bcc6/joyMIDI-HW/joyMIDI/others/README.md

# Install InteractiveHtmlBom
Unzip and copy to folder C:\Program Files\KiCad\share\kicad\scripting\plugins
