bcc6/joyMIDI-HW/joyMIDI/schematic/Bottom.png

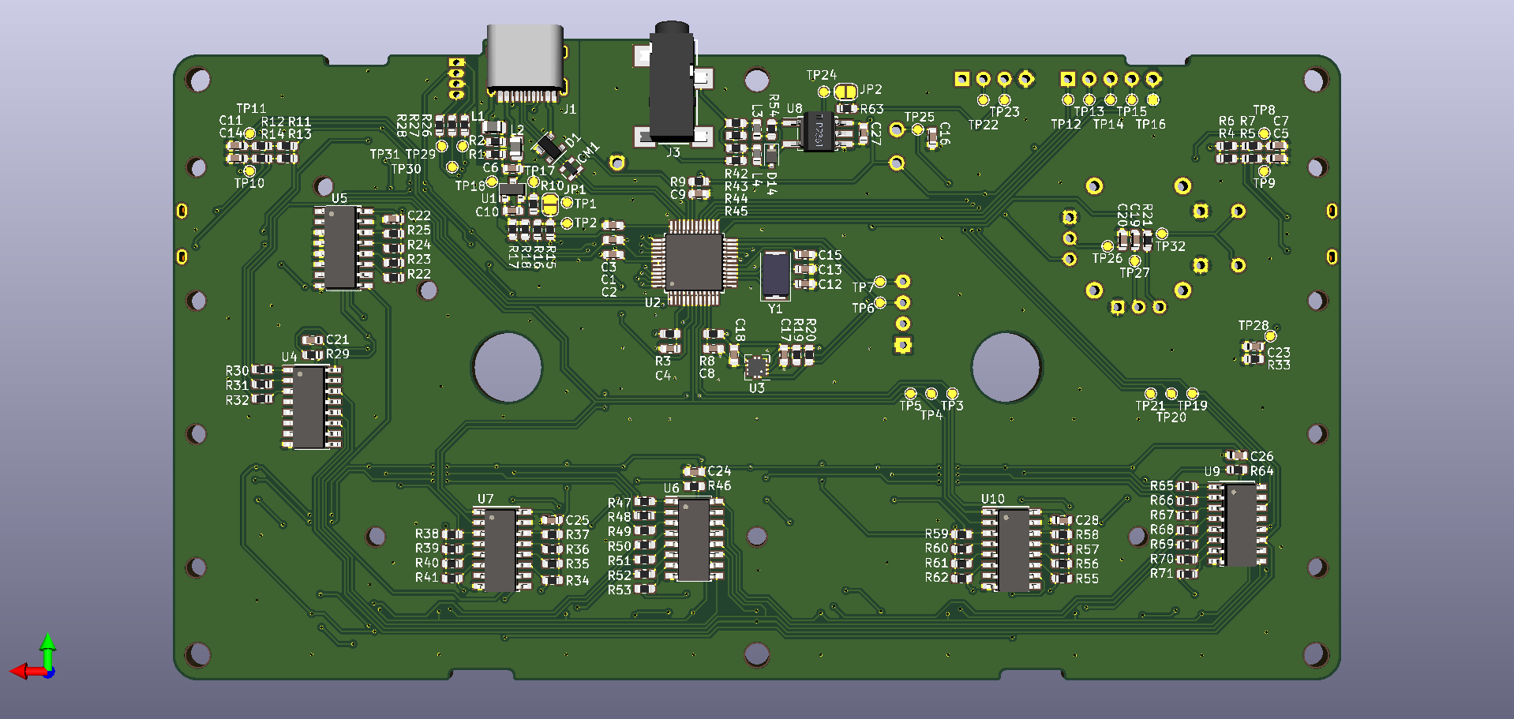
joyMIDI/schematic/Bottom.png
