bcc6/joyMIDI-HW/joyMIDI/schematic/Top.png

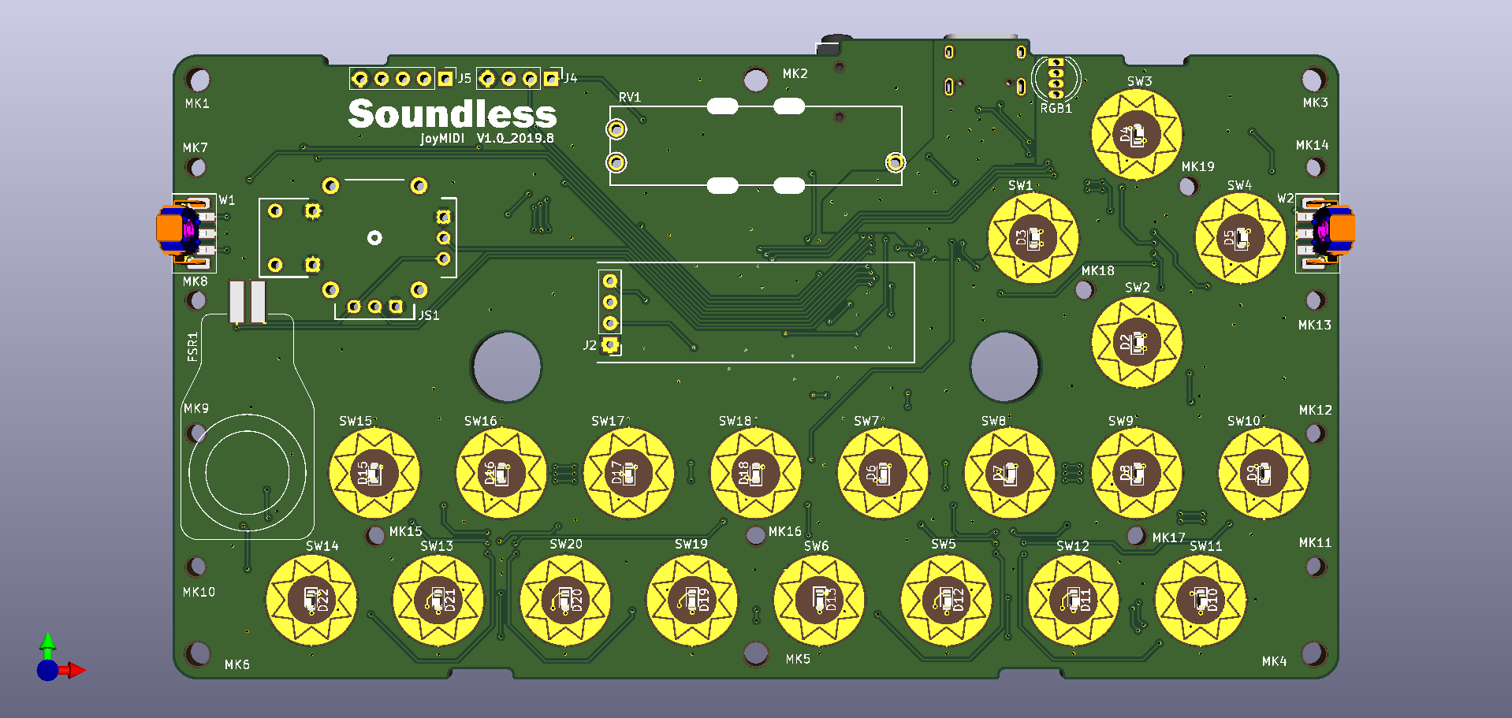
joyMIDI/schematic/Top.png
