bcc6/joyMIDI-HW/joyMIDI/__to_factory/joyMIDI_BOM _Parts (190529).xlsx

Sheet: BOM & PARTs
No. | Reference | P/N | Value | Package | Quantity | Mount
1 | C1, C2, C8, C9, C17, C18, C21, C22, C24, C25, C26, C27, C28 |  | 100n | C0603 | 13 | Yes
2 | C12, C13 |  | 20p | C0603 | 2 | Yes
3 | C16, C19, C20, C23 |  | 1n | C0603 | 4 | Yes
4 | C3, C4, C15 |  | 1u | C0603 | 3 | Yes
5 | C5, C7, C11, C14 |  | 10n | C0603 | 4 | Yes
6 | C6, C10 |  | 4.7u, 10V | C0603 | 2 | Yes
7 | CM1 | TDK, ACM2012-900-2P-TL002 | Common Choke, 90R@100MHz |  | 1 | Yes(0R)
8 | D1 | Nexperia, PRTR5V0U2X | ESD protection | SOT-143B | 1 | No
9 | D14 | 1N4148WS | Diode | SOD-323F | 1 | Yes
10 | D2, D3, D4, D5, D6, D7, D8, D9, D10, D11, D12, D13, D15, D16, D17, D18, D19, D20, D21, D22 | Everlight, 19-217/W1D | LED, Pure White | LED0603 | 20 | Yes
11 | FSR1 | Uneo, GD10-20N | Forcing sensing resister |  | 1 | Yes | http://www.uneotech.com/uneo/us/online-store-4/96/gs0001-4-uneo.html Eric Huang 黃爾均 <erichuang@uneotech.com>
12 | J1 | Amphenol, 12401610E4#2A | USB Type C, Receptacle |  | 1 | Yes
13 | J2 |  | Pin Header (OLED) | 1x4_2.54mm | 1 | Yes
14 | J3 | CUI, SJ-2524-SMT | Audio Jack, 2.5mm |  | 1 | Yes
15 | J4 |  | Pin Header (Debug) | 1x4_2.54mm | 1 | No
16 | J5 |  | Pin Header (Programmer) | 1x5_2.54mm | 1 | No
17 | JS1 | 普耀(福哥), FJM10K-S1B10K | Joystick |  | 1 | Yes | http://www.polyshine.cn/uploadFile/FJM10K-2013-12-02-04-50-09.pdf
18 | L1 |  | 0R | L0805 | 1 | No
19 | L2 |  | Ferrite Bead, 600R, 1A | L0805 | 1 | Yes (0R)
20 | L3, L4 | TDK, MMZ1608Y102BT | Ferrite Bead | L0603 | 2 | Yes (0R)
21 | R1, R2 |  | 5.1K | R0603 | 2 | Yes
22 | R19, R20 |  | 4.7K | R0603 | 2 | Yes
23 | R26, R27, R28, R54 |  | 220 | R0603 | 4 | Yes
24 | R29, R30, R31, R32, R46, R47, R48, R49, R50, R51, R52, R53, R64, R65, R66, R67, R68, R69, R70, R71 |  | 1K | R0603 | 20 | Yes
25 | R3, R4, R5, R6, R7, R11, R12, R13, R14, R21, R22, R23, R24, R25, R34, R35, R36, R37, R38, R39, R40, R41, R55, R56, R57, R58, R59, R60, R61, R62 |  | 10K | R0603 | 30 | Yes
26 | R33 |  | 2K | R0603 | 1 | Yes
27 | R43, R44 |  | NC | R0603 | 2 | No
28 | R8, R9, R10, R15, R16, R17, R18, R42, R45, R63 |  | 0R | R0603 | 10 | Yes
29 | RV1 | 普耀(福哥), F2031-NN0SC2B10K | Slider, Travel 20mm, 3Pin 10KOhm | (操作力度為最鬆) | 1 | Yes | http://www.polyshine.cn/uploadFile/Fxx31-2015-09-21-01-46-32.pdf
30 | RGB1 |  | LED, RGB Clear Common Anode | D4.8mm-4pin, Straw hat | 1 | Yes | https://detail.1688.com/offer/1232851898.html?spm=a2615.7691456.newlist.51.319e58cc8Eowc5
31 | U1 | AIC, AIC1746-33(GU3TR, PK3TR) | LDO, 3.3V | SOT-23 | 1 | Yes
32 | U2 | Nuvoton, M452LE6AE | MCU, 128K/32K | LQFP-48, 7x7mm | 1 | Yes
33 | U3 | Bosch, BMA253 | G-sensor | LGA-12, 2x2mm | 1 | Yes | https://www.mouser.com/datasheet/2/783/Bosch_01242017_BMA253-1217713.pdf
34 | U4, U6, U9 | 74HC595D |  | SOIC-16, 3.9x9.9mm | 3 | Yes
35 | U5, U7, U10 | 74HC165D |  | SOIC-16, 3.9x9.9mm | 3 | Yes
36 | U8 | Toshiba, TLP2361 | Photocoupler | SO-5, 4.4x3.6mm | 1 | Yes
37 | W1, W2 | ALPS, EC05E1220202 | Encoder |  | 2 | Yes | https://www.alps.com/prod/info/E/HTML/Encoder/Incremental/EC05E/EC05E1220202.html
38 | Y1 | TXC, 7A-12.000MAAJ-T | 12MHz, 20pf | SMD 5032, 2Pin | 1 | Yes
No. | Reference | P/N | Value | Package | Quantity | Mount
1 | OLED |  | 128x32, White color, I2C | 0.91" | 1 | Yes | https://item.taobao.com/item.htm?spm=a1z09.2.0.0.46752e8dvI4tNo&id=41978488408&_u=32he15hv61af
2 | Optical fiber |  | SOTT-4 | Φ 4mm (裁切長度為 55mm) | 1 | Yes | https://item.taobao.com/item.htm?spm=a312a.7700824.w4002-2232455176.13.4ecf4f0cVMZXpB&id=16114844505
3 | Heat shrink tube |  |  | Φ 5mm (裁切長度為 16mm) | 1 | Yes
4 | Joystick cap |  | Plastic |  | 1 | Yes | https://item.taobao.com/item.htm?spm=a1z09.2.0.0.46752e8dkIGIcR&id=556587653085&_u=42he15hv3e95
5 | Slider cap |  | Plastic |  | 1 | Yes | https://item.taobao.com/item.htm?id=566418891937&ns=1&abbucket=8 (https://item.taobao.com/item.htm?spm=a230r.1.14.61.41f04349yJPBXQ&id=566418891937&ns=1&abbucket=8)
6 | PCB |  | Matte Black / White font

Sheet: Price
No. | Reference | P/N | Value | Package | Qty | Mount | 需求數量 | 實際數量 | $(美金) |  | 註解 | pads
1 | C1, C2, C8, C9, C17, C18, C21, C22, C24, C25, C26, C27, C28 |  | 100n | C0603 | 13 | Yes | 6500 | 8000 | 9.86 | 淘寶(华科洋) | CC0603KRX7R9BB104 | 2
2 | C12, C13 |  | 20p | C0603 | 2 | Yes | 1000 | 4000 | 6.9574 | 淘寶(华科洋) | CC0603JRNPO9BN200 | 2
3 | C16, C19, C20, C23 |  | 1n | C0603 | 4 | Yes | 2000 | 4000 | 6.9574 | 淘寶(华科洋) | CL10B102KB8NNNC | 2
4 | C3, C4, C15 |  | 1u | C0603 | 3 | Yes | 1500 | 4000 | 6.9574 | 淘寶(华科洋) | CL10B105KO8NNNC | 2
5 | C5, C7, C11, C14 |  | 10n | C0603 | 4 | Yes | 2000 | 4000 | 6.9574 | 淘寶(华科洋) | CL10B103KB8NNNC | 2
6 | C6, C10 |  | 4.7u, 10V | C0603 | 2 | Yes | 1000 | 4000 | 6.9574 | 淘寶(华科洋) | CL10A475KP8NNNC | 2
7 | CM1 | TDK, ACM2012-900-2P-TL002 | Common Choke, 90R@100MHz |  | 1 | Yes | 500 | 2000 | 57.99 | 淘寶(銘晖) | ACM2012-900-2P-T002 0805 90R | 4
8 | D1 | Nexperia, PRTR5V0U2X | ESD protection | SOT-143B | 1 | Yes | 500 | 3000 | 69.57 | 淘寶(锴成达) | PRTR5V0U2X | 4
9 | D14 | 1N4148WS | Diode | SOD-323F | 1 | Yes | 500 | 3000 | 17.39 | 淘寶(华科洋) | 1N4148WS SOD-323 丝印T4 | 2
10 | D2, D3, D4, D5, D6, D7, D8, D9, D10, D11, D12, D13, D15, D16, D17, D18, D19, D20, D21, D22 | Everlight, 19-217/W1D | LED, Pure White | LED0603 | 20 | Yes | 10000 | 12000 | 43.48 | 淘寶(华科洋) | 不明品牌 | 2
11 | FSR1 | Uneo, GD10-20N | Forcing sensing resister |  | 1 | Yes | 500 | 1000 | 1087.07 | 1688(力感科技) | RP-C10-ST | 2
12 | J1 | SHWB, USCX-16FX-XXMX-21 | USB Type C, Receptacle, 16pin |  | 1 | Yes | 500 | 500 | 27.49 | 1688(深洪威博) | USCX-16FX-XXMX-21 | 20
13 | J2 |  | Pin Header (OLED) | 1x4_2.54mm | 1 | No | 0 | 0 | 0 |  |  | 0
14 | J3 | CUI, SJ-2524-SMT | Audio Jack, 2.5mm |  | 1 | Yes | 500 | 1000(strip) | 28.97 | 淘寶(博泰鑫) | PJ-208A | 4
15 | J4 |  | Pin Header (Debug) | 1x4_2.54mm | 1 | No |  | 0 | 0 |  |  | 0
16 | J5 |  | Pin Header (Programmer) | 1x5_2.54mm | 1 | No |  | 0 | 0 |  |  | 0
17 | JS1 | 普耀(福哥), FJM10K-S1B10K | Joystick |  | 1 | Yes | 500 | 500 | 144.66 | 淘寶(金鑫开关) | FJM10K-S1B10K | 14
18 | L1 |  | 0R | L0805 | 1 | No |  | 0 | 0 |  |  | 0
19 | L2 |  | Ferrite Bead, 600R, 1A | L0805 | 1 | Yes (0R) | 500 | 5000 | 3.88 | 淘寶(华科洋) | 0805 0R 1% | 2
20 | L3, L4 | TDK, MMZ1608Y102BT | Ferrite Bead | L0603 | 2 | Yes | 1000 | 4000 | 6.36 | 淘寶(华科洋) | GZ1608D102TF | 2
21 | R1, R2 |  | 5.1K | R0603 | 2 | Yes | 1000 | 5000 | 2.29 | 淘寶(华科洋) | 0603 5.1K 1% | 2
22 | R19, R20 |  | 4.7K | R0603 | 2 | Yes | 1000 | 5000 | 2.29 | 淘寶(华科洋) | 0603 4.7K 1% | 2
23 | R26, R27, R28, R54 |  | 220 | R0603 | 4 | Yes | 2000 | 5000 | 2.29 | 淘寶(华科洋) | 0603 220R 1% | 2
24 | R29, R30, R31, R32, R46, R47, R48, R49, R50, R51, R52, R53, R64, R65, R66, R67, R68, R69, R70, R71 |  | 1K | R0603 | 20 | Yes | 10000 | 15000 | 6.87 | 淘寶(华科洋) | 603 1K 1% | 2
25 | R3, R4, R5, R6, R7, R11, R12, R13, R14, R21, R22, R23, R24, R25, R34, R35, R36, R37, R38, R39, R40, R41, R55, R56, R57, R58, R59, R60, R61, R62 |  | 10K | R0603 | 30 | Yes | 15000 | 20000 | 9.16 | 淘寶(华科洋) | 0603 10K 1% | 2
26 | R33 |  | 3.3K | R0603 | 1 | Yes | 500 | 5000 | 2.29 | 淘寶(华科洋) | 0603 3.3K 1% | 2
27 | R43, R44 |  | NC | R0603 | 2 | No |  | 0 | 0 |  |  | 0
28 | R8, R9, R10, R15, R16, R17, R18, R42, R45, R63 |  | 0R | R0603 | 10 | Yes | 5000 | 10000 | 4.58 | 淘寶(华科洋) | 0603 0R 1% | 2
29 | RV1 | 普耀(福哥), F2031-NN0SC2B10K | Slider, Travel 20mm, 3Pin 10KOhm |  | 1 | Yes | 500 | 500 | 79.56 | 1688(东莞博聪) | SL2031N | 3
30 | RGB1 |  | LED, RGB Clear Common Anode | D4.8mm-4pin, Straw hat | 1 | Yes | 500 | 500 | 14.47 | 1688(亚磊) |  | 4
31 | U1 | AIC, AIC1746-33(GU3TR, PK3TR) | LDO, 3.3V | SOT-23 | 1 | Yes | 500 | 1000(strip) | 57.85 | 淘寶(pingcon) | AIC1746-33PK3TR | 3
32 | U2 | Nuvoton, M452LE6AE | MCU, 128K/32K | LQFP-48, 7x7mm | 1 | Yes | 500 | 500 | 925 | nuvoton direct | M452LE6AE | 48
33 | U3 | Bosch, BMA253 | G-sensor | LGA-12, 2x2mm | 1 | Yes | 500 | 1000(strip) | 209.69 | 淘寶(浩吉发) | STK8BA53 | 12
34 | U4, U6, U9 | 74HC595D |  | SOIC-16, 3.9x9.9mm | 3 | Yes | 1500 | 2500 | 115.69 | 淘寶(华科洋) | ¥0.32 | 16
35 | U5, U7, U10 | 74HC165D |  | SOIC-16, 3.9x9.9mm | 3 | Yes | 1500 | 2500 | 115.69 | 淘寶(华科洋) | ¥0.32 | 16
36 | U8 | Toshiba, TLP2361 | Photocoupler | SO-5, 4.4x3.6mm | 1 | Yes | 500 | 1000(strip) | 231.38 | 淘寶(兴宏泰) | 需再詢價 | 5
37 | W1, W2 | ALPS, EC05E1220202 | Encoder |  | 2 | Yes | 1000 | 1000(strip) | 477.37 | 淘寶(涛利) | 需再詢價 | 7
38 | Y1 | TXC, 7A-12.000MAAJ-T | 12MHz, 20pf | SMD 5032, 2Pin | 1 | Yes | 500 | 1000 | 79.54 | 淘寶(华科洋) | ¥0.55, 12MHZ 20PF ±10PPM | 2
 |  |  |  |  |  |  |  |  | 3867.517 |  |  | 198
No. | Reference | P/N | Value | Package | Qty | Mount | 需求數量 | 實際數量 | $(美金)
1 | OLED |  | 128x32, White color, I2C | 0.91" | 1 |  | 500 | 500 | 759.22 | 淘寶(叁陆壹) | 焊排針
2 | Optical fiber |  | SOTT-4 | Φ 4mm (裁切長度為 55mm) | 1 |  | 30 | 30 | 39.05 | 淘寶(四叶子) | 共約30米
3 | Heat shrink tube |  |  | Φ 5mm (裁切長度為 16mm) | 1 |  | 10 | 10 | 6.1 | 露天(heat2020) | 共約10米
4 | Joystick cap |  | Plastic |  | 1 |  | 500 | 500 | 47.01 | 淘寶(华智)
5 | Slider cap |  | Plastic |  | 1 |  | 500 | 500 | 20.97 | 淘寶(华图贸易)
6 | PCB |  | Matte Black / White font | 8連板 | 1 |  | 500 | 500 | 1000 | 淘寶(快客電路) | 需再詢價
7 | 鋼板 |  |  |  | 1 |  | 1 | 1 | 100 | 淘寶(快客電路) | 需再詢價
8 | SMT |  |  |  | 1 |  | 1 | 1 | 1200 | 淘寶(快客電路) | 需再詢價
9 | 包材 |  |  |  |  |  |  |  | 0
 |  |  |  |  |  |  |  |  | 3172.35
