bcc6/joyMIDI-HW/joyMIDI/others/dxf/Placement.DXF

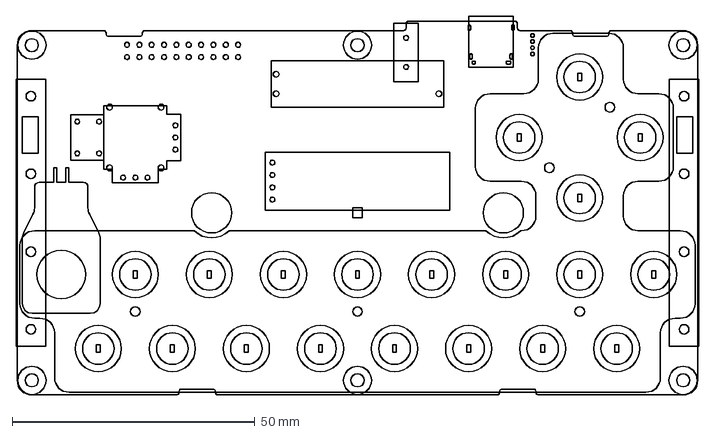
[picture p3: CAD file, 2019-04-24]
joyMIDI/others/dxf/Placement.DXF
140.4 x 78.0 mm
