bcc6/joyMIDI-HW/joyMIDI/others/Solidworks-RubberPad/RubberPad.SLDPRT

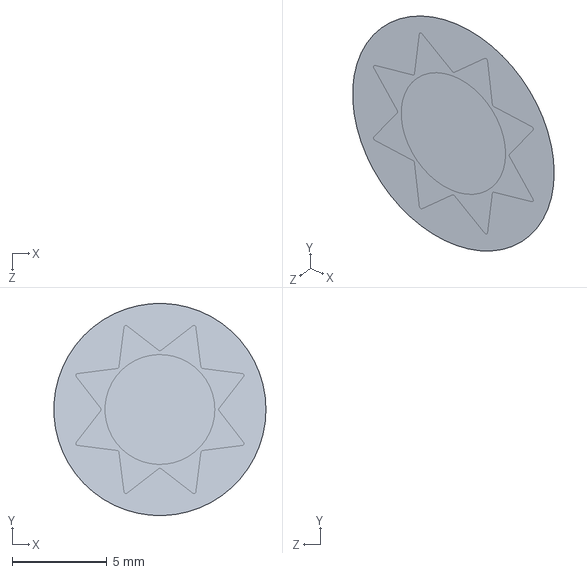
[picture p4: CAD file, 2019-04-24]
joyMIDI/others/Solidworks-RubberPad/RubberPad.SLDPRT
11.2 x 11.2 x 0 mm
