bcc6/joyMIDI-HW/joyMIDI/others/dxf/EdgeCut.DXF

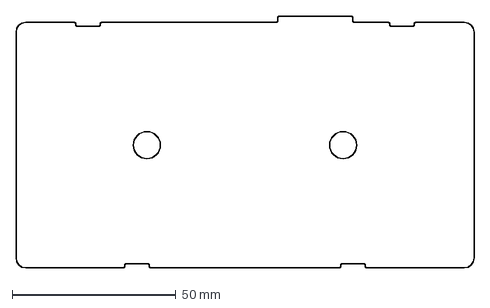
[picture p5: CAD file, 2019-04-24]
joyMIDI/others/dxf/EdgeCut.DXF
140.0 x 76.9 mm
