bcc6/joyMIDI-HW/(list of files, cad)

Other CAD files:
joyMIDI/others/Solidworks-RubberPad/RubberPad.DXF
