bcc6/joyMIDI-HW/joyMIDI/schematic/joyMIDI - schematic.pdf

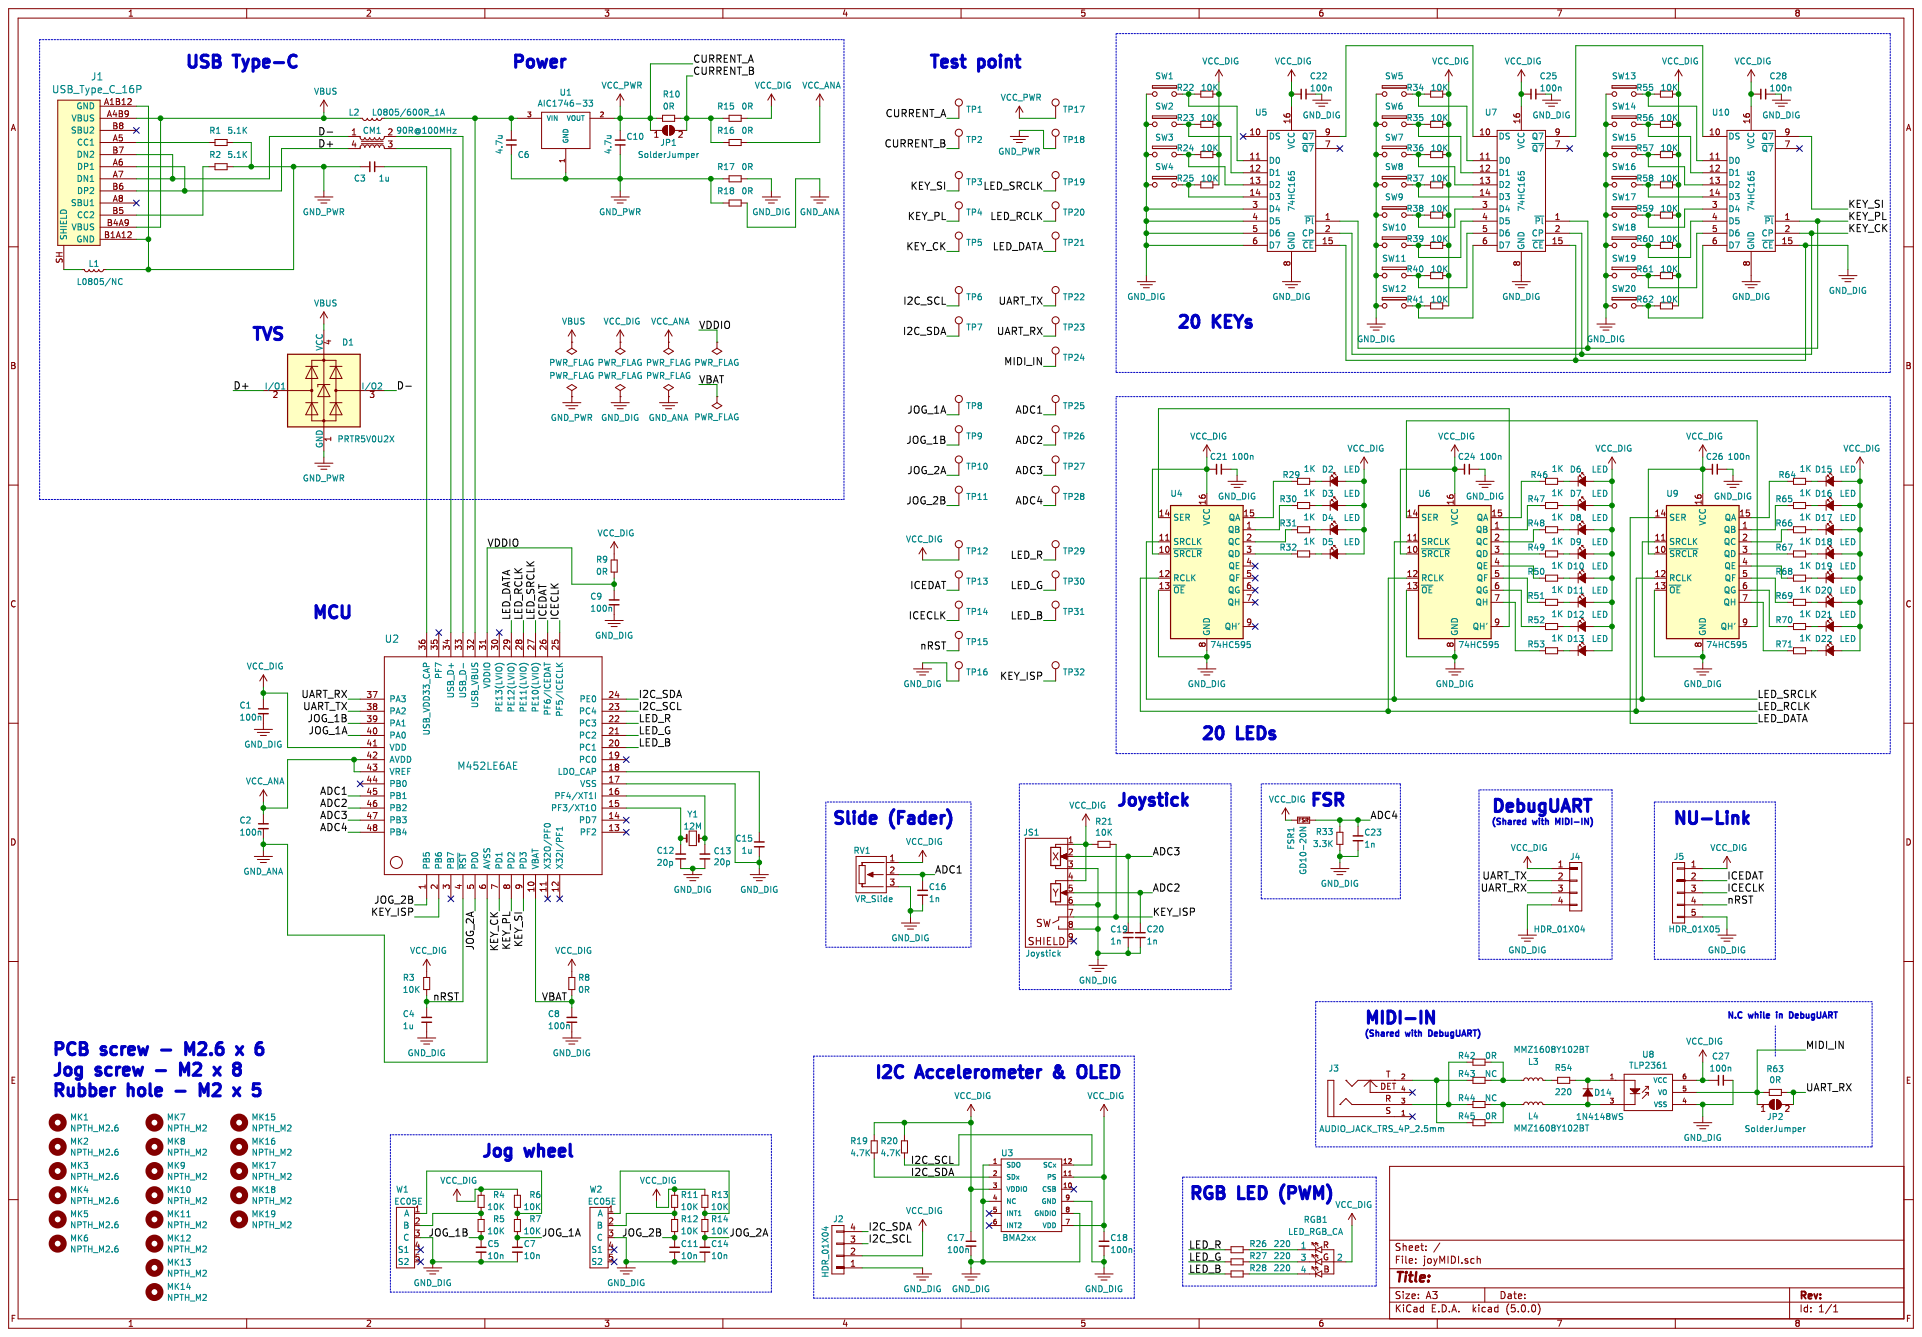
[picture p6: page 1]
