bcc6/joyMIDI-HW/joyMIDI/joyMIDI.kicad_pcb

## KiCad design joyMIDI/joyMIDI.kicad_pcb (2019-08-20)

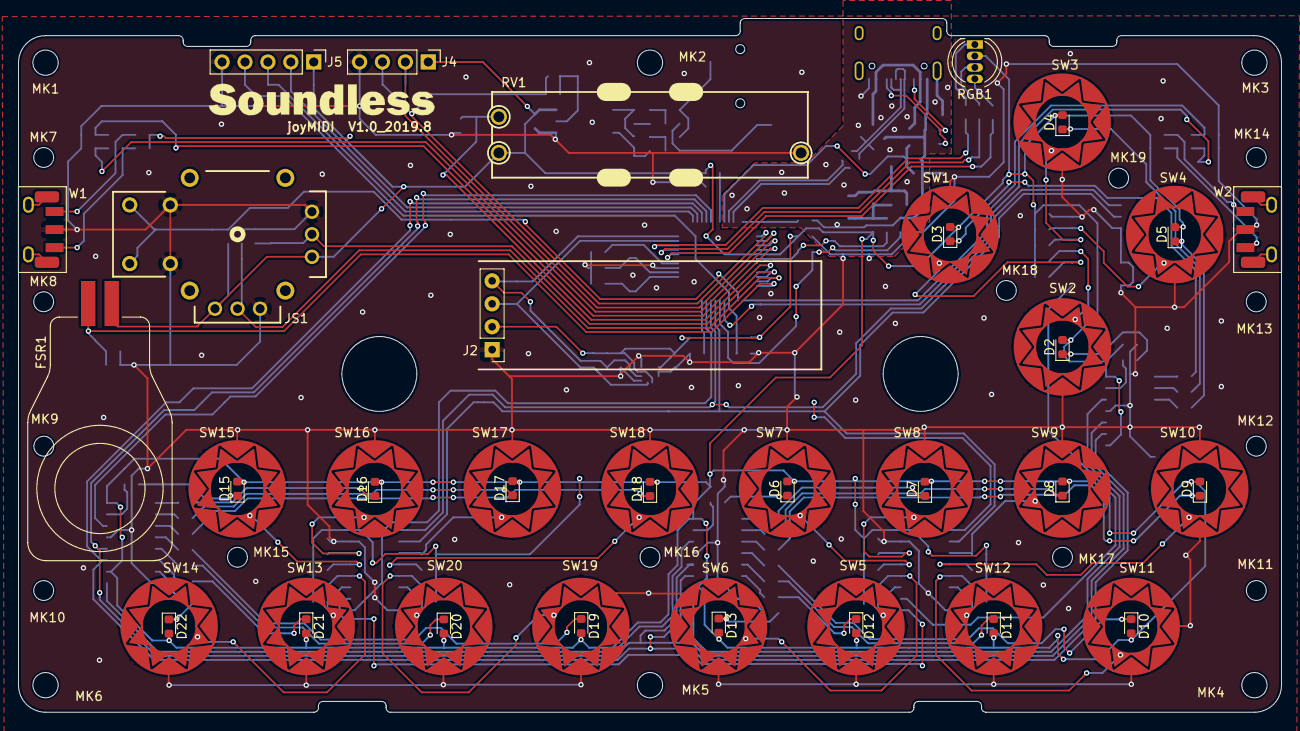
[picture p7: board joyMIDI.kicad_pcb from above]

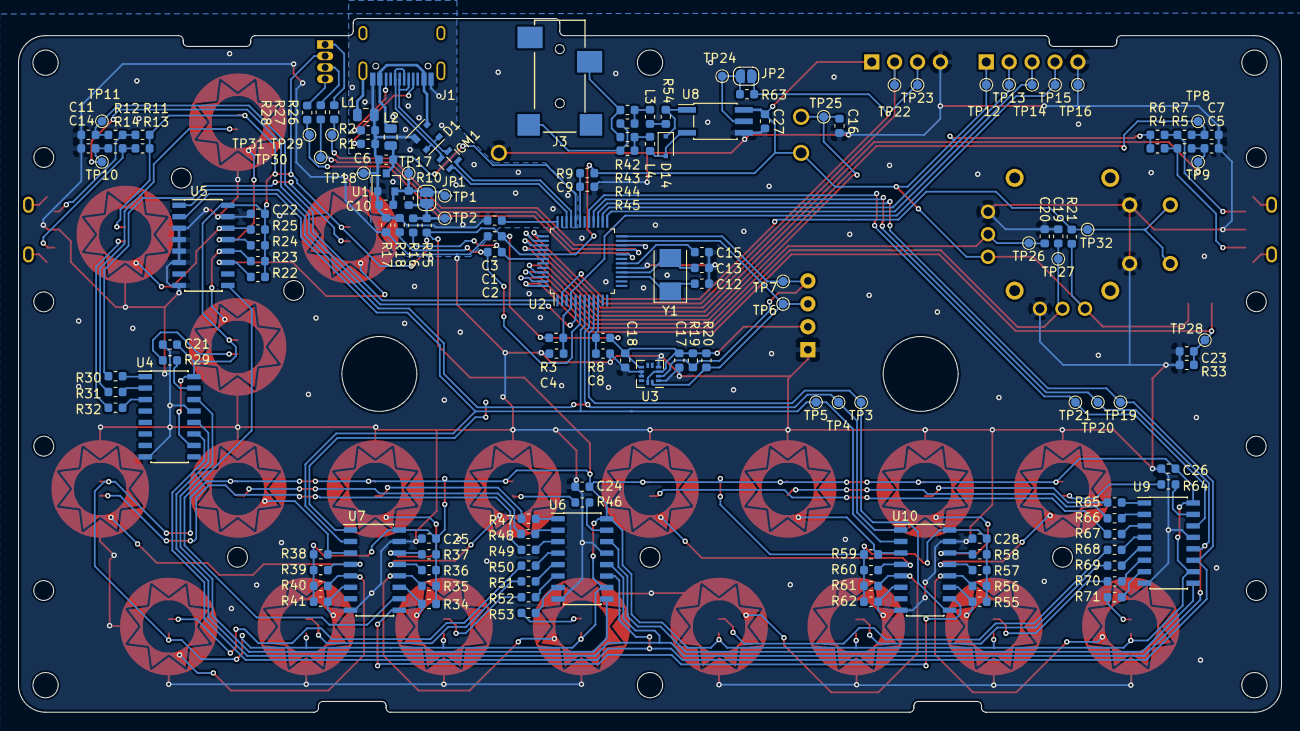
[picture p8: board joyMIDI.kicad_pcb from below]

Board: 2 copper layers, 140.0 x 76.9 mm, 221 parts (153 on the bottom side), 126 nets.

Parts:
C1, C2, C8, C9, C17, C18, C21, C22, C24, C25, C26, C27, C28: 100n; C_0603_1608Metric
C3, C4, C15: 1u; C_0603_1608Metric
C5, C7, C11, C14: 10n; C_0603_1608Metric
C6, C10: 4.7u; C_0603_1608Metric
C12, C13: 20p; C_0603_1608Metric
C16, C19, C20, C23: 1n; C_0603_1608Metric
CM1: 90R@100MHz; CommonChoke_Dual0603
D1: PRTR5V0U2X; PRTR5V0U2X_SOT-143B
D2, D3, D4, D5, D6, D7, D8, D9, D10, D11, D12, D13, D15, D16, D17, D18, D19, D20, D21, D22: LED; LED_0603_1608Metric
D14: 1N4148WS; D_SOD-323F
FSR1: GD10-20N; FSR_GD10-20N
J1: USB_Type_C_16P; HRO_TYPE-C-31-M-12
J2: HDR_01X04; Pin_Header_Straight_1x04_Pitch2.54mm_SmallHole
J3: AUDIO_JACK_TRS_4P_2.5mm; AUDIO_JACK_2.5mm_SJ-2524-SMT
J4: HDR_01X04; PinHeader_1x04_P2.54mm_Vertical
J5: HDR_01X05; PinHeader_1x05_P2.54mm_Vertical
JP1, JP2: SolderJumper; SolderJumper-2_P1.3mm_Open_RoundedPad1.0x1.5mm
JS1: Joystick; Joystick_FJM10K-S
L1: L0805/NC; L_0805_2012Metric
L2: L0805/600R_1A; L_0805_2012Metric
L3, L4: MMZ1608Y102BT; L_0603_1608Metric
MK1, MK2, MK3, MK4, MK5, MK6: NPTH_M2.6; NPTH_2.8mm_M2.6
MK7, MK8, MK9, MK10, MK11, MK12, MK13, MK14, MK15, MK16, MK17, MK18, MK19: NPTH_M2; NPTH_2.2mm_M2
R1, R2: 5.1K; R_0603_1608Metric
R3, R4, R5, R6, R7, R11, R12, R13, R14, R21, R22, R23, R24, R25, R34, R35, R36, R37, R38, R39, R40, R41, R55, R56, R57, R58, R59, R60, R61, R62: 10K; R_0603_1608Metric
R8, R9, R10, R15, R16, R17, R18, R42, R45, R63: 0R; R_0603_1608Metric
R19, R20: 4.7K; R_0603_1608Metric
R26, R27, R28, R54: 220; R_0603_1608Metric
R29, R30, R31, R32, R46, R47, R48, R49, R50, R51, R52, R53, R64, R65, R66, R67, R68, R69, R70, R71: 1K; R_0603_1608Metric
R33: 3.3K; R_0603_1608Metric
R43, R44: NC; R_0603_1608Metric
RGB1: LED_RGB_CA; LED_D4.8mm-4
RV1: VR_Slide; VR_Slide_F2031-NN
SW1, SW2, SW3, SW4, SW5, SW6, SW7, SW8, SW9, SW10, SW11, SW12, SW13, SW14, SW15, SW16, SW17, SW18, SW19, SW20: SW; RubberPad
TP1, TP2, TP3, TP4, TP5, TP6, TP7, TP8, TP9, TP10, TP11, TP12, TP13, TP14, TP15, TP16, TP17, TP18, TP19, TP20, TP21, TP22, TP23, TP24, TP25, TP26, TP27, TP28, TP29, TP30, TP31, TP32: TestPoint; TestPoint_Pad_D1.0mm
U1: AIC1746-33; SOT-23
U2: M452LE6AE; LQFP-48_7x7mm_P0.5mm
U3: BMA2xx; BMA2xx_LGA-12
U4, U6, U9: 74HC595; SOIC-16_3.9x9.9mm_P1.27mm
U5, U7, U10: 74HC165; SOIC-16_3.9x9.9mm_P1.27mm
U8: TLP2361; SO-5_4.4x3.6mm_P1.27mm
W1, W2: EC05E; EC05E1220202
Y1: 12M; Crystal_SMD_5032-2Pin_5.0x3.2mm

Connections:
/ADC1: C16.1, RV1.2, TP25.1, U2.45
/ADC2: C20.1, JS1.5, TP26.1, U2.46
/ADC3: C19.1, JS1.2, TP27.1, U2.47
/ADC4: C23.1, FSR1.1, R33.2, TP28.1, U2.48
/CURRENT_B: JP1.2, R10.1, R15.2, R16.2, TP2.1
/D+: CM1.4, D1.2, J1.A6, J1.B6
/D-: CM1.1, D1.3, J1.A7, J1.B7
/I2C_SCL: J2.3, R20.2, TP6.1, U2.23, U3.12
/I2C_SDA: J2.4, R19.2, TP7.1, U2.24, U3.2
/ICECLK: J5.3, TP14.1, U2.25
/ICEDAT: J5.2, TP13.1, U2.26
/JOG_1A: C7.1, R7.1, TP8.1, U2.40
/JOG_1B: C5.1, R5.1, TP9.1, U2.39
/JOG_2A: C14.1, R14.1, TP10.1, U2.5
/JOG_2B: C11.1, R12.1, TP11.1, U2.1
/KEY_CK: TP5.1, U2.7, U5.2, U7.2, U10.2
/KEY_ISP: JS1.7, R21.1, TP32.1, U2.2
/KEY_PL: TP4.1, U2.8, U5.1, U7.1, U10.1
/KEY_SI: TP3.1, U2.9, U10.9
/LED_B: R28.2, TP31.1, U2.20
/LED_DATA: TP21.1, U2.29, U9.14
/LED_G: R27.2, TP30.1, U2.21
/LED_R: R26.2, TP29.1, U2.22
/LED_RCLK: TP20.1, U2.28, U4.12, U6.12, U9.12
/LED_SRCLK: TP19.1, U2.27, U4.11, U6.11, U9.11
/MIDI_IN: JP2.1, R63.1, TP24.1, U8.5
/UART_RX: J4.3, JP2.2, R63.2, TP23.1, U2.37
/UART_TX: J4.2, TP22.1, U2.38
/VBAT: C8.1, R8.2, U2.10
/VDDIO: C9.1, R9.1, U2.31
/nRST: C4.1, J5.4, R3.2, TP15.1, U2.4
GND_ANA: C2.2, R18.1, U2.6
GND_DIG: C1.2, C4.2, C5.2, C7.2, C8.2, C9.2, C11.2, C12.2, C13.2, C14.2, C15.2, C16.2, C17.2, C18.2, C19.2, C20.2, C21.2, C22.1, C23.2, C24.2, C25.1, C26.2, C27.1, C28.1, J2.1, J4.4, J5.5, JS1.3, JS1.6, JS1.8, R17.1, R33.1, RV1.3, SW1.1, SW2.1, SW3.1, SW4.1, SW5.1, SW6.1, SW7.1, SW8.1, SW9.1, SW10.1, SW11.1, SW12.1, SW13.1, SW14.1, SW15.1, SW16.1, SW17.1, SW18.1, SW19.1, SW20.1, TP16.1, U2.17, U3.1, U3.4, U3.8, U3.9, U4.8, U4.13, U5.3, U5.4, U5.5, U5.6, U5.8, U5.15, U6.8, U6.13, U7.8, U7.15, U8.4, U9.8, U9.13, U10.8, U10.15, W1.3, W2.3
GND_PWR: C3.1, C6.2, C10.2, D1.1, J1.A1B12, J1.B1A12, L1.1, R1.1, R2.1, R17.2, R18.2, TP18.1, U1.1
unnamed: C3.2, U2.36
unnamed: C6.1, L2.1, U1.3, U2.32
unnamed: C12.1, U2.15, Y1.1
unnamed: C13.1, U2.16, Y1.2
unnamed: C15.1, U2.18
unnamed: CM1.2, U2.33
unnamed: CM1.3, U2.34
unnamed: D2.1, R29.2
unnamed: D3.1, R30.2
unnamed: D4.1, R31.2
unnamed: D5.1, R32.2
unnamed: D6.1, R46.2
unnamed: D7.1, R47.2
unnamed: D8.1, R48.2
unnamed: D9.1, R49.2
unnamed: D10.1, R50.2
unnamed: D11.1, R51.2
unnamed: D12.1, R52.2
unnamed: D13.1, R53.2
unnamed: D14.1, R54.2, U8.1
unnamed: D14.2, L4.2, U8.3
unnamed: D15.1, R64.2
unnamed: D16.1, R65.2
unnamed: D17.1, R66.2
unnamed: D18.1, R67.2
unnamed: D19.1, R68.2
unnamed: D20.1, R69.2
unnamed: D21.1, R70.2
unnamed: D22.1, R71.2
unnamed: J1.A5, R1.2
unnamed: J1.B5, R2.2
unnamed: J1.SH, L1.2
unnamed: J3.2, R43.1, R45.1
unnamed: J3.3, R42.1, R44.1
unnamed: L3.1, R42.2, R43.2
unnamed: L3.2, R54.1
unnamed: L4.1, R44.2, R45.2
unnamed: R4.1, R5.2, W1.2
unnamed: R6.1, R7.2, W1.1
unnamed: R11.1, R12.2, W2.2
unnamed: R13.1, R14.2, W2.1
unnamed: R22.1, SW1.2, U5.11
unnamed: R23.1, SW2.2, U5.12
unnamed: R24.1, SW3.2, U5.13
unnamed: R25.1, SW4.2, U5.14
unnamed: R26.1, RGB1.1
unnamed: R27.1, RGB1.3
unnamed: R28.1, RGB1.4
unnamed: R29.1, U4.15
unnamed: R30.1, U4.1
unnamed: R31.1, U4.2
unnamed: R32.1, U4.3
unnamed: R34.1, SW5.2, U7.11
unnamed: R35.1, SW6.2, U7.12
unnamed: R36.1, SW7.2, U7.13
unnamed: R37.1, SW8.2, U7.14
unnamed: R38.1, SW9.2, U7.3
unnamed: R39.1, SW10.2, U7.4
unnamed: R40.1, SW11.2, U7.5
unnamed: R41.1, SW12.2, U7.6
unnamed: R46.1, U6.15
unnamed: R47.1, U6.1
unnamed: R48.1, U6.2
unnamed: R49.1, U6.3
unnamed: R50.1, U6.4
unnamed: R51.1, U6.5
unnamed: R52.1, U6.6
unnamed: R53.1, U6.7
unnamed: R55.1, SW13.2, U10.11
unnamed: R56.1, SW14.2, U10.12
unnamed: R57.1, SW15.2, U10.13
unnamed: R58.1, SW16.2, U10.14
unnamed: R59.1, SW17.2, U10.3
unnamed: R60.1, SW18.2, U10.4
unnamed: R61.1, SW19.2, U10.5
unnamed: R62.1, SW20.2, U10.6
unnamed: R64.1, U9.15
unnamed: R65.1, U9.1
unnamed: R66.1, U9.2
unnamed: R67.1, U9.3
unnamed: R68.1, U9.4
unnamed: R69.1, U9.5
unnamed: R70.1, U9.6
unnamed: R71.1, U9.7
unnamed: U4.14, U6.9
unnamed: U5.9, U7.10
unnamed: U6.14, U9.9
unnamed: U7.9, U10.10
VBUS: D1.4, J1.A4B9, J1.B4A9, L2.2
VCC_ANA: C2.1, R16.1, U2.42, U2.43
VCC_DIG: C1.1, C17.1, C18.1, C21.1, C22.2, C24.1, C25.2, C26.1, C27.2, C28.2, D2.2, D3.2, D4.2, D5.2, D6.2, D7.2, D8.2, D9.2, D10.2, D11.2, D12.2, D13.2, D15.2, D16.2, D17.2, D18.2, D19.2, D20.2, D21.2, D22.2, FSR1.2, J2.2, J4.1, J5.1, JS1.1, JS1.4, R3.1, R4.2, R6.2, R8.1, R9.2, R11.2, R13.2, R15.1, R19.1, R20.1, R21.2, R22.2, R23.2, R24.2, R25.2, R34.2, R35.2, R36.2, R37.2, R38.2, R39.2, R40.2, R41.2, R55.2, R56.2, R57.2, R58.2, R59.2, R60.2, R61.2, R62.2, RGB1.2, RV1.1, TP12.1, U2.41, U3.3, U3.7, U3.11, U4.10, U4.16, U5.16, U6.10, U6.16, U7.16, U8.6, U9.10, U9.16, U10.16
VCC_PWR: C10.1, JP1.1, R10.2, TP1.1, TP17.1, U1.2
