bcc6/joyMIDI-HW/(commit log)

2019-05-27 V1.0 2019.5 Change USB connector to 16pin from 24pin Add placement file for SMT
    [joyMIDI-B.Cu.gbl, joyMIDI-B.Mask.gbs, joyMIDI-B.SilkS.gbo, joyMIDI-Edge.Cuts.gm1, joyMIDI-F.Cu.gtl, joyMIDI-F.Mask.gts, joyMIDI-F.SilkS.gto, joyMIDI-all-pos.csv]
2019-05-27 Fixed something
    [joyMIDI.kicad_pcb]
2019-05-28 Update gerber
    [joyMIDI-B.Cu.gbl, joyMIDI-B.Mask.gbs, joyMIDI-B.Paste.gbp, joyMIDI-B.SilkS.gbo, joyMIDI-Edge.Cuts.gm1, joyMIDI-F.Cu.gtl, joyMIDI-F.Mask.gts, joyMIDI-F.Paste.gtp]
2019-05-29 Update modules
    [joyMIDI.kicad_pcb]
2019-05-29 Update all to Kicad 5.1.2
    [joyMIDI-B.Cu.gbl, joyMIDI-B.Mask.gbs, joyMIDI-B.SilkS.gbo, joyMIDI-B_Cu.gbl, joyMIDI-B_Mask.gbs, joyMIDI-B_Paste.gbp, joyMIDI-B_SilkS.gbo, joyMIDI-Edge.Cuts.gm1]
2019-05-29 Add fabrication files
    [joyMIDI.sch, joyMIDI_BOM _Parts (190529).xlsx]
2019-08-20 Change Logo
    [joyMIDI-B_Cu.gbl, joyMIDI-B_Mask.gbs, joyMIDI-B_Paste.gbp, joyMIDI-B_SilkS.gbo, joyMIDI-Edge_Cuts.gm1, joyMIDI-F_Cu.gtl, joyMIDI-F_Mask.gts, joyMIDI-F_Paste.gtp]
